zachtemkin/synth-machine-libDaisy/README.md

# synthMachine

## Author

<!-- Insert Your Name Here -->

## Description

<!-- Describe your example here -->
