zachtemkin/synth-machine-libDaisy/hardware/v0.3/README.md

# synthMachine carrier board v0.3

The revision that was fabricated (September 2026). The next revision, with
the fixes from `../NEXT_REVISION.md` applied, is in `../v0.4/`.

A 100 x 100 mm carrier for the Daisy Seed (or Seed3) that drives the synth: the
19-button key matrix, 5 pots, USB-C for MIDI and power, a MAX98306 class-D amp
for the two enclosed Adafruit speakers, and a TPA6138A2 headphone amp with a
switched jack that mutes the speakers when headphones are plugged in.

Buttons and pots stay on the panel and connect with JST-XH leads, so the board
can be mounted anywhere in the enclosure and every panel part unplugs for
service. USB-C, the headphone jack and the Seed's own USB port all sit on the
top board edge, so one enclosure wall carries all three.

Everything here is generated by `gen_kicad.py` so the schematic and the PCB
always agree with each other and with the pin map in `../synthMachine.cpp`.

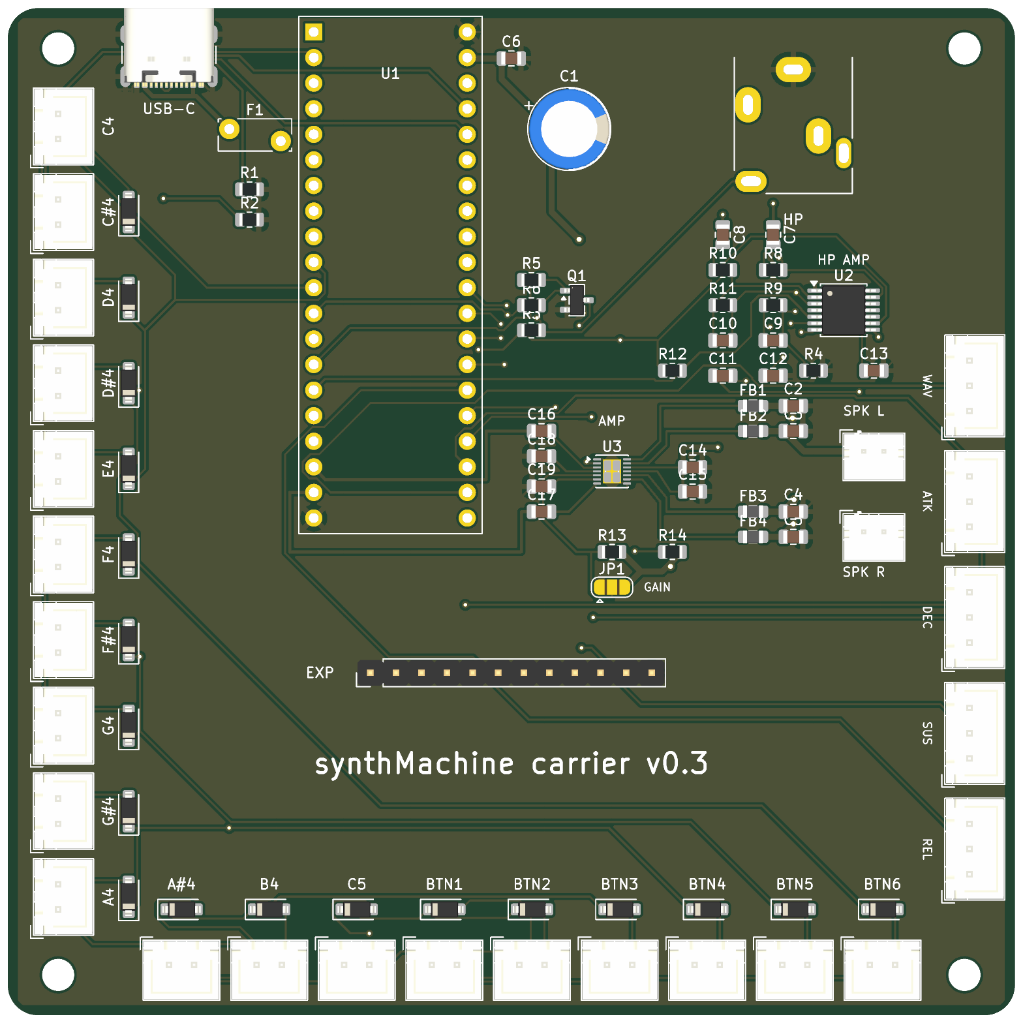
[picture p2: hardware/v0.3/pcb_render.png]
PCB render


## Open it

Open `synth_machine.kicad_pro` in KiCad 9 or 10. ERC is clean (a fresh KiCad 10
install reports "library not in configuration" warnings until it has created
its default library tables on first launch). The PCB is placed and routed with
GND pours on both sides. Remaining DRC items are hole-clearance nits inside
KiCad's own USB-C footprint and a few thermal-spoke notes; both can be ignored.

## Regenerate and route

```bash
KICAD_PY=/Applications/KiCad/KiCad.app/Contents/Frameworks/Python.framework/Versions/Current/bin/python3
$KICAD_PY hardware/v0.3/gen_kicad.py                              # schematic + placed PCB
$KICAD_PY hardware/v0.3/route.py --java <java25>/bin/java --jar freerouting-2.4.1.jar
$KICAD_PY hardware/v0.3/route.py --pours-only                     # rebuild just the GND pours
sh hardware/v0.3/fab.sh                                           # Gerbers, BOM, CPL, test print
```

`gen_kicad.py` overwrites the schematic and PCB, so re-run `route.py` after it.
`route.py` lays down the hand-routed nets in `PREROUTES` (audio paths and the
MAX98306 fan-out) locked, exports a Specctra DSN, runs Freerouting headless
(needs Java 25; a portable JRE from adoptium.net works), imports the result, then
re-adds and fills the pours. Net classes: 0.2 mm default with 0.15 mm clearance,
0.6 mm "Power" for +5V and the filtered speaker lines, 0.4 mm for VBUS, 0.3 mm
for the amp-to-bead speaker lines.

## What is on the board

| Block | Parts | Notes |
|---|---|---|
| Daisy Seed | U1 on 2x 1x20 sockets | USB end on the top board edge. Seed rev 4/5/7 and Seed3 share the pinout. |
| Key headers | K1..K19, JST-XH 2-pin, 10 down the left edge and 9 along the bottom | One lead per button. Pin 1 = matrix row (or D10 for C4), pin 2 = diode (or GND for C4). Silkscreen names each header. |
| Matrix diodes | D1..D18, 1N4148W SOD-123 | Next to each header. Columns D4..D9 driven low, rows D1..D3 with pull-ups, exactly as `scanButtonMatrix()`. |
| Spare buttons | K14..K19 = BTN1..BTN6 | On the 6 unused matrix slots (c0 r0) (c0 r1) (c1 r0) (c2 r0) (c3 r0) (c4 r0), the `-1` entries in `NOTE_MAPPING`. |
| Pot headers | J10..J14, JST-XH 3-pin down the right edge | 1 = +3V3A, 2 = wiper to A0..A4, 3 = AGND. 10k linear panel-mount pots. |
| USB-C | J1 (GCT USB4105), R1/R2 5k1, F1 2.5A polyfuse (Bourns MF-R250) | Data to D30/D29 = Daisy "external" USB; firmware must use `MidiUsbTransport::Config::EXTERNAL`. VBUS is the only power input, no switch. |
| Power | F1 -> +5V; C1 470u, C6 100n | Feeds Seed VIN and the speaker amp. |
| Speaker amp | U3 MAX98306ETD+T (TDFN-14 EP), C16..C19 1u, C14 10u, C15 100n, R13/R14 100k, JP1 | Adafruit #987's circuit on the board, single-ended inputs from the Seed line out. Gain 9 dB via R13 (about 2 W into 4 ohm); JP1 straps GAIN to GND (18 dB) or PVDD (12 dB); no R13 and JP1 open = 6 dB. R14 pulls ~SHDN up, Q1 pulls it low to mute. |
| Speakers | FB1..FB4 0805 beads + C2..C5 220p, J5/J6 JST-PH | MAX98306 datasheet EMI filter, then the JST-PH sockets that match the Adafruit speaker plugs. |
| Headphone amp | U2 TPA6138A2PWR (TSSOP-14), C7/C8 1u, R8..R11 10k, C9/C10 47p, C11/C12 1u, C13 10u, R12 100k | DirectPath: ground-centred output, no output caps, 40 mW into 32 ohm from 3V3. Unity gain (raise R9/R11 for more). Mute active-low, pulled up by R12, D14 can mute it. |
| Headphone jack | J7 CUI SJ1-3515N on the top edge, R3 100k, R4 10k, R5/R6 10k, Q1 MMBT3904 | Tip/ring from U2. The NC switch contact is the plug detect: near 0 V unplugged, about 0.8 V plugged (Q1's base clamps it, see below). Q1 then mutes the speaker amp. D11 = firmware speaker mute, D13 reads HP_DET. |
| Expansion | J8 1x12, fit a female socket | HP_MUTE, D26, D27, A5..A8, HP_DET, MUTE, 3V3, 5V, GND. |
| Mounting | H1..H4 M3, 5 mm in from each corner | |

## Wiring the panel

- **Buttons:** each button gets a 2-pin XH lead with 2.8 mm (0.110") female
  disconnects on the button end. Polarity does not matter. Pre-crimped XH leads
  (Amazon kits, 20 to 30 cm) are the easy route; solder the disconnects on.
- **Pots:** 3-pin XH lead per pot: pin 1 to one outer lug, pin 2 to the wiper,
  pin 3 to the other outer lug. Swap the outer lugs if a pot turns backwards.
- **Speakers:** plug straight into J5/J6. Keep both plugged the same way so the
  speakers stay in phase.
- **Board position:** anywhere. The only constraint is the top edge, which
  needs cutouts for USB-C, the headphone jack and the Seed's USB.

## Why the headphones have their own amp

The MAX98306 outputs are bridge-tied class-D with no ground reference: no series
caps on the speakers, never join the two channels' minus legs, and no headphones
on them (their sleeve is a shared ground). So the headphone jack gets its own
TPA6138A2 driven from the same Seed line out, and the jack's switch contact
mutes the speaker amp. Plug in, speakers go quiet; unplug, they return.

## Ordering (JLCPCB)

`sh hardware/v0.3/fab.sh` writes everything into `hardware/v0.3/fab/`:

- `synth_machine_gerbers.zip`: upload unchanged for the PCB. 2 layers, 100 x
  100 mm, FR-4 1.6 mm, 1 oz, HASL lead-free or ENIG, "remove order number".
- `jlcpcb_bom.csv` and `jlcpcb_cpl.csv`: for SMT assembly, top side, economic.
  Every SMD part carries an LCSC number: the two amps (extended parts), the
  matrix diodes, the ferrite beads, Q1 and all 0805 passives. The CPL
  pre-rotates TSSOP/TDFN parts by -90 degrees for JLC's convention; in the
  placement preview check that U2's and U3's pin-1 dots sit on the silkscreen
  triangles, and that the 18 diodes all show the cathode band on the pin-1 end.
- `synth_machine_1to1_11x17.pdf`: 1:1 print, mostly useful now to check the
  enclosure cutouts on the top edge.

Hand-soldered after assembly: Seed sockets, 19 + 5 XH headers, 2 PH sockets,
the jack, the USB-C receptacle, the fuse and C1. `digikey_tht_parts.csv` is a
Digi-Key list for those plus the XH housings/contacts, pots and speakers.

## Before ordering

1. Seed pin-1 corner on `DaisySeed_2x20` against a real Seed.
2. USB-C and jack positions against your enclosure wall: the USB-C shell
   overhangs the edge by about 1 mm, the jack nose is flush.
3. USB power budget: two 4 ohm speakers at full tilt exceed a USB-A port's
   500 mA. Use a USB-C supply or a 1.5 A-capable port.

## Firmware

`../synthMachine.cpp` builds for this board with `make HW=carrier` (a plain
`make` targets the breadboard prototype). The carrier profile enables
`EXTERNAL` USB MIDI, drives the speaker mute on D11 with the rules below, reads
HP_DET on D13 and holds HP_MUTE (D14) low until a plug is detected.

**v0.3 bug: D13 never sees the plug.** With headphones in, HP_DET only rises
to about 0.8 V, not 3V3: R3 (100k) pulls up through R5 (10k) into Q1's
base-emitter junction, and the divider settles at a diode drop plus a little.
That is enough to switch Q1 on and mute the speakers in hardware, but a digital
input reads it as low, so the firmware never unmutes the headphone amp. The
fix on existing boards is a wire from EXP pin 8 (HP_DET) to EXP pin 4 (A5) and
a firmware built with `HP_DET=adc`, which reads the plug detect through the
ADC with a 0.5 V threshold. The proper fix is in `../NEXT_REVISION.md`, and v0.4 has it.

**Board without its USB-C.** J1 is the only source of +5V, and the Seed does
not pass its own USB supply out through VIN. A carrier built without J1 needs
5 V fed into EXP pin 11 (+5V) with ground on pin 12, or the speaker amp is
unpowered. MIDI then goes through the Seed's own port: build with
`MIDI_USB=seed`.

BTN1 and BTN2 (the left-hand pair on the panel, c0 r0 and c0 r1) are octave
down and up; holding both is shift, which turns the wave-shape pot into master
volume. BTN3..6 pick what the four right-hand pots (A1..A4) control: BTN3 =
envelope (attack, decay, sustain, release; the default), BTN4 = effects
(filter cutoff, resonance, delay, reverb), BTN5 = LFO 1 and BTN6 = LFO 2
(rate, depth, shape, destination). The prototype's spare buttons run the other way through this numbering
(its left pair is c4 r0 and c3 r0), and `AUX_MAPPING` in the firmware carries
both boards.

`make KEYLOG=1` builds a variant that prints every key event on the Seed's
micro-USB serial port (`screen /dev/cu.usbmodem* 115200`) for checking panel
wiring. After any DFU flash, press RESET: the Seed does not bring USB up after
the DFU handoff, so neither MIDI nor the serial log appears until you do.

### MUTE drive rules (this revision)

MUTE (D11) and HP_DET meet at Q1's base through R6 and R5 (10k each), and
HP_DET's pull-up R3 is 100k. So:

- driving MUTE high mutes the speakers regardless of the jack;
- leaving MUTE as an input lets the jack decide;
- driving MUTE **low** holds Q1 off and keeps the speakers on even with
  headphones in, because R6 to ground beats R3. Firmware never drives it low;
  "unmute" is tri-state.

While nothing is plugged in, the jack's switch ties HP_DET to the headphone
amp's left output, so audio peaks above about 0.65 V would turn Q1 on and gate
the speaker amp. Firmware keeps the headphone amp muted (HP_MUTE low) until a
plug is detected, which holds that node near ground.

The speakers default to on at reset, so firmware can only race the codec's
start-up pop (it wins, since GPIO is set before the Seed init), and DFU mode or
a crash leaves them live.

### Next revision

See [NEXT_REVISION.md](NEXT_REVISION.md): the running list of changes for the
next board spin, starting with a separate transistor and pull-up for MUTE so
the speakers default to muted and firmware can use plain push-pull drive.
