zachtemkin/synth-machine-libDaisy/hardware/enclosure-concepts/concept-1-walnut-desktop.png

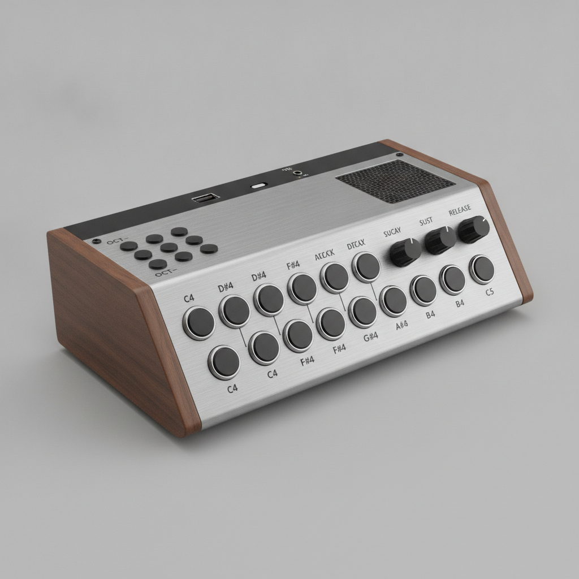
hardware/enclosure-concepts/concept-1-walnut-desktop.png
