zachtemkin/synth-machine-libDaisy/hardware/enclosure-concepts/concept-2-pocket-speaker.png

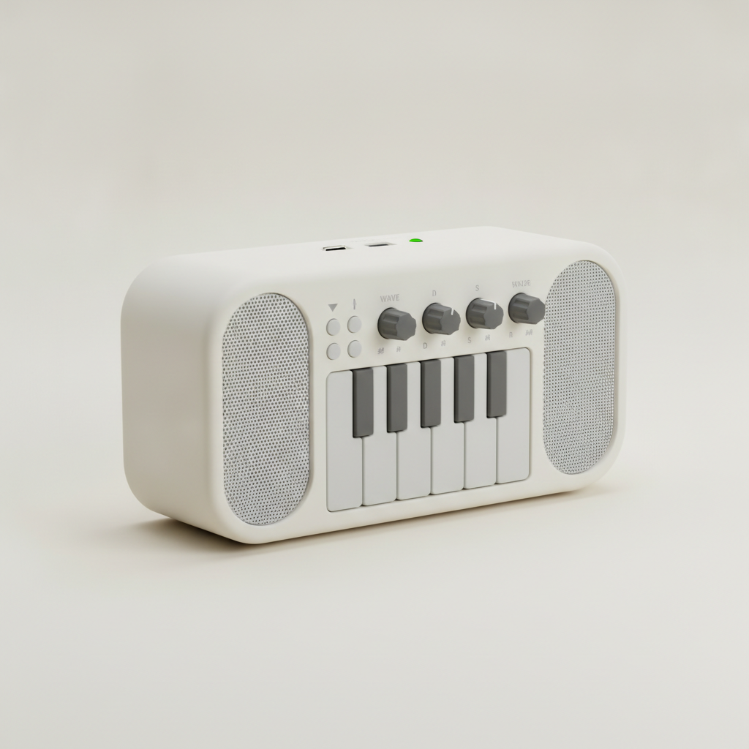
hardware/enclosure-concepts/concept-2-pocket-speaker.png
