zachtemkin/synth-machine-libDaisy/hardware/enclosure-concepts/concept-3-bent-steel.png

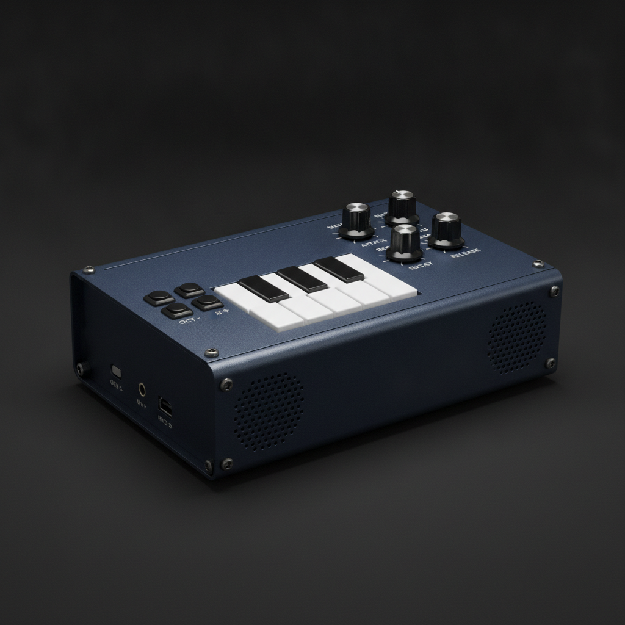
hardware/enclosure-concepts/concept-3-bent-steel.png
