zachtemkin/synth-machine-libDaisy/hardware/v0.4/digikey_tht_parts.csv

Digi-Key Part Number | Manufacturer Part Number | Quantity | Customer Reference | Description
455-2247-ND | B2B-XH-A(LF)(SN) | 42 | K1-K19, J16 x2 + spares | JST XH 2-pin header, vertical (buttons, power switch); skip: placed by JLCPCB standard assembly (C158012)
455-2248-ND | B3B-XH-A(LF)(SN) | 3 | J10 x2 + spare | JST XH 3-pin header, vertical (volume pot); skip: placed by JLCPCB standard assembly (C144394)
455-1704-ND | B2B-PH-K-S(LF)(SN) | 8 | J5,J6,J17 x2 + spares | JST PH 2-pin socket (speakers, battery); skip: placed by JLCPCB standard assembly (C131337)
S7018-ND | PPTC201LFBN-RC | 4 | U1 sockets x2 | 1x20 female header, 2 per Seed
PPTC081LFBN-RC | PPTC081LFBN-RC | 3 | J9 x2 + spare | 1x8 female socket for the display header
PPTC121LFBN-RC | PPTC121LFBN-RC | 3 | J8 x2 + spare | 1x12 female socket for the expansion header
CP1-3515N-ND | SJ1-3515N | 3 | J7 x2 + spare | CUI 3.5mm switched stereo jack
 | TYPE-C-31-M-12 | 0 | J1 | HRO USB-C 16-pin receptacle, LCSC C165948 (JLCPCB basic part); placed by the assembler, not a Digi-Key line
P124219-ND | EEU-FR1A471 | 3 | C1 x2 + spare | Panasonic 470uF 10V radial 8mm, 3.5mm pitch
PDB181-E420K-103B-ND | PDB181-E420K-103B | 3 | volume pot x2 + spare | Bourns 16mm 10k linear pot, solder lugs
 |  | 8 | encoders x2 boards | Adafruit 4991 I2C QT rotary encoder breakout, 4 per board, with STEMMA QT cables; set a different address on each
 |  | 2 | panel power switch | Any panel-mount SPST toggle or slide switch; it only switches the boost's enable pin
 |  | 2 | battery | 1S LiPo 2000 mAh or larger with protection PCB and JST-PH plug (Adafruit 2011 or similar); verify + on J17 pin 1
