zachtemkin/synth-machine-libDaisy/hardware/enclosure-concepts/concept-4-3d-printed.png

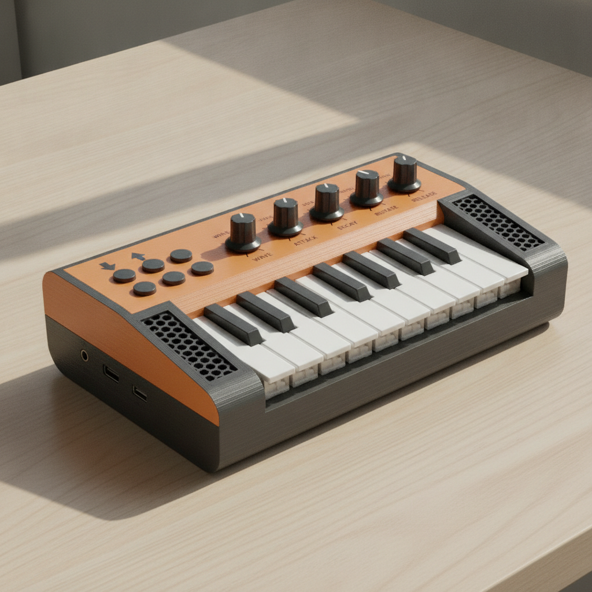
hardware/enclosure-concepts/concept-4-3d-printed.png
