zachtemkin/synth-machine-libDaisy/hardware/v0.4/synth_machine.kicad_pcb

## KiCad design hardware/v0.4/synth_machine.kicad_pcb (2026-09-18)

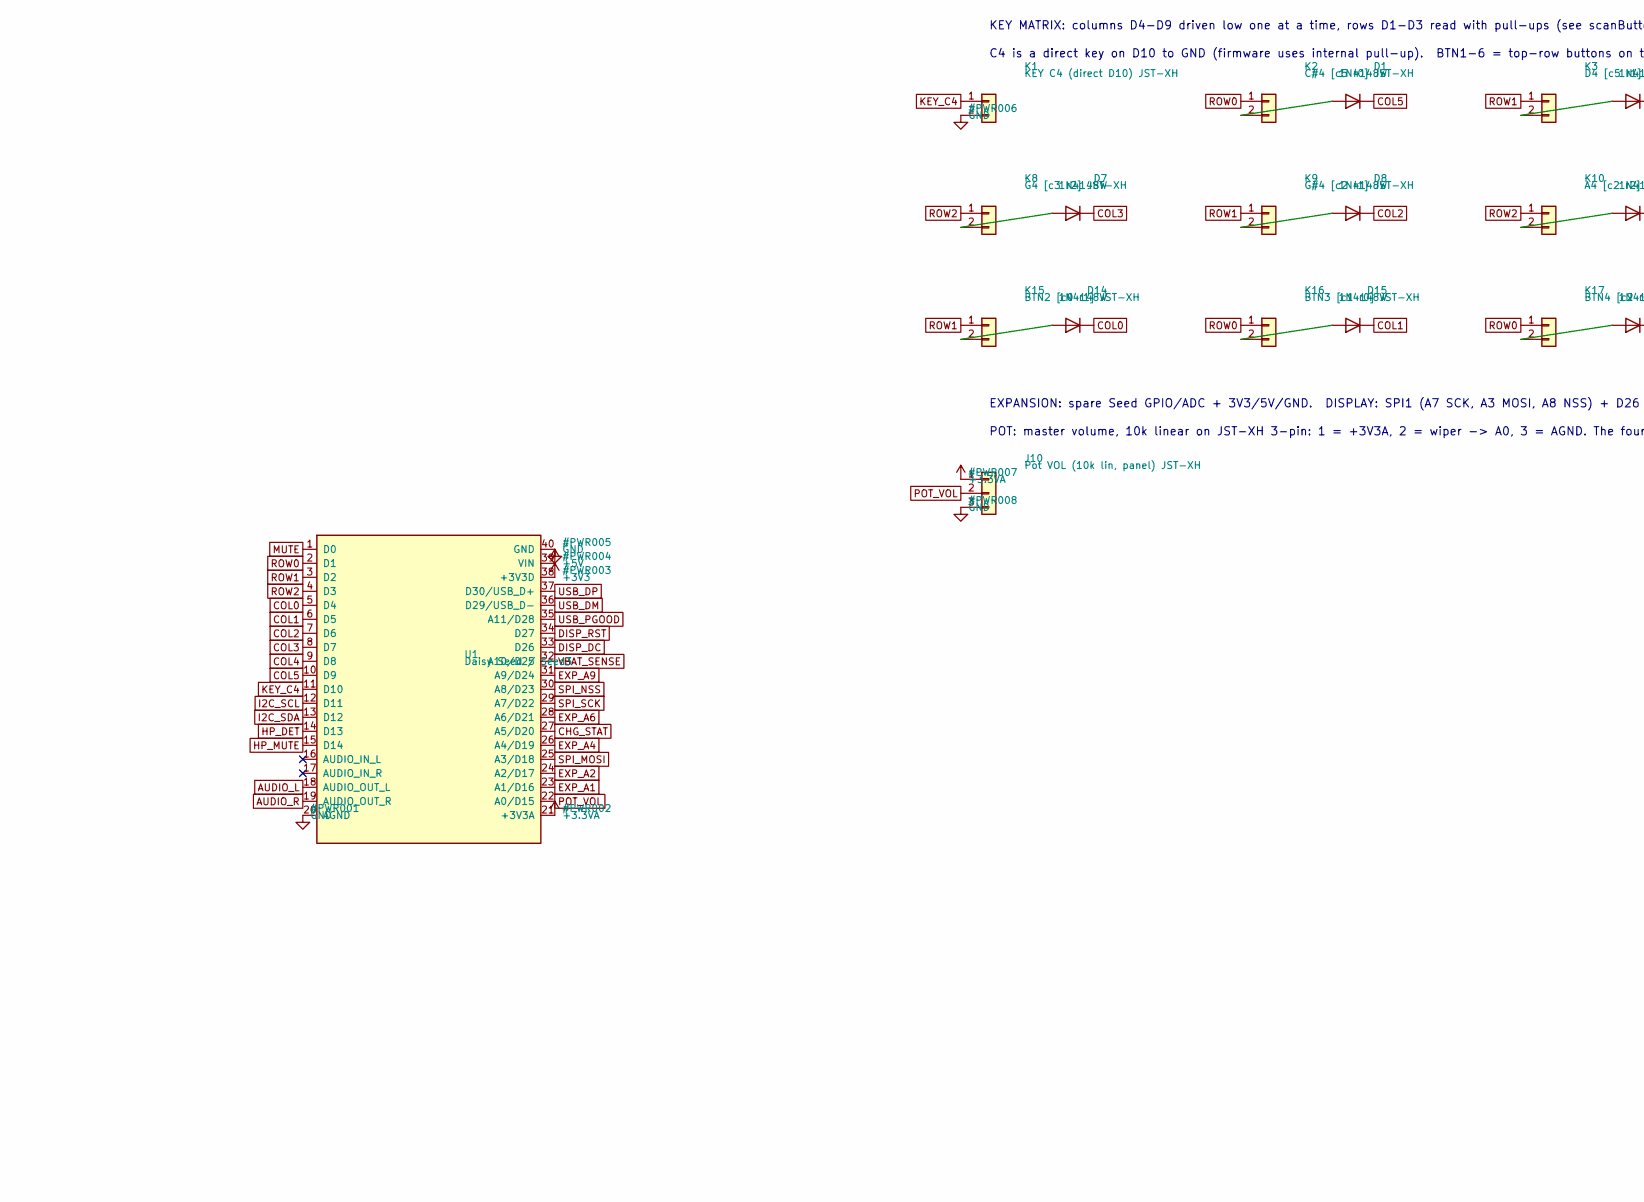
[picture p7: schematic synth_machine.kicad_sch, synthMachine carrier board, part in row 1, column 1]

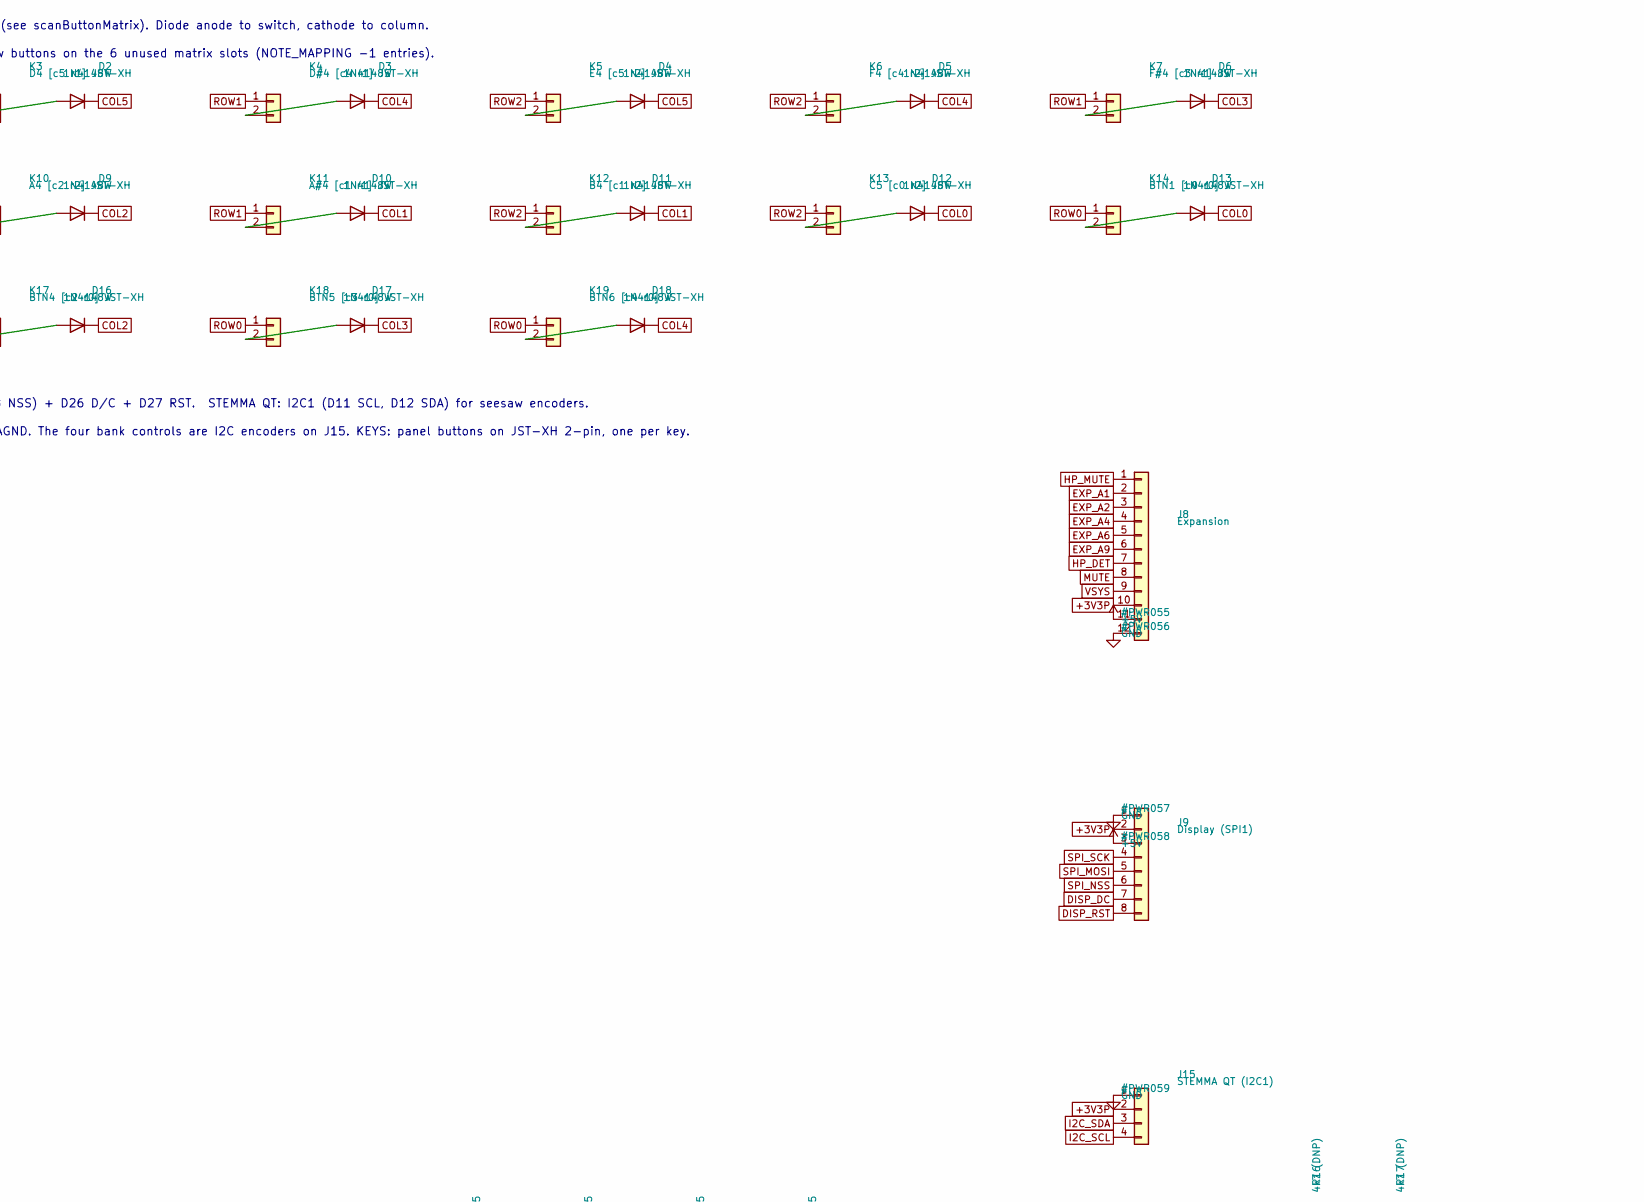
[picture p8: schematic synth_machine.kicad_sch, synthMachine carrier board, part in row 1, column 2]

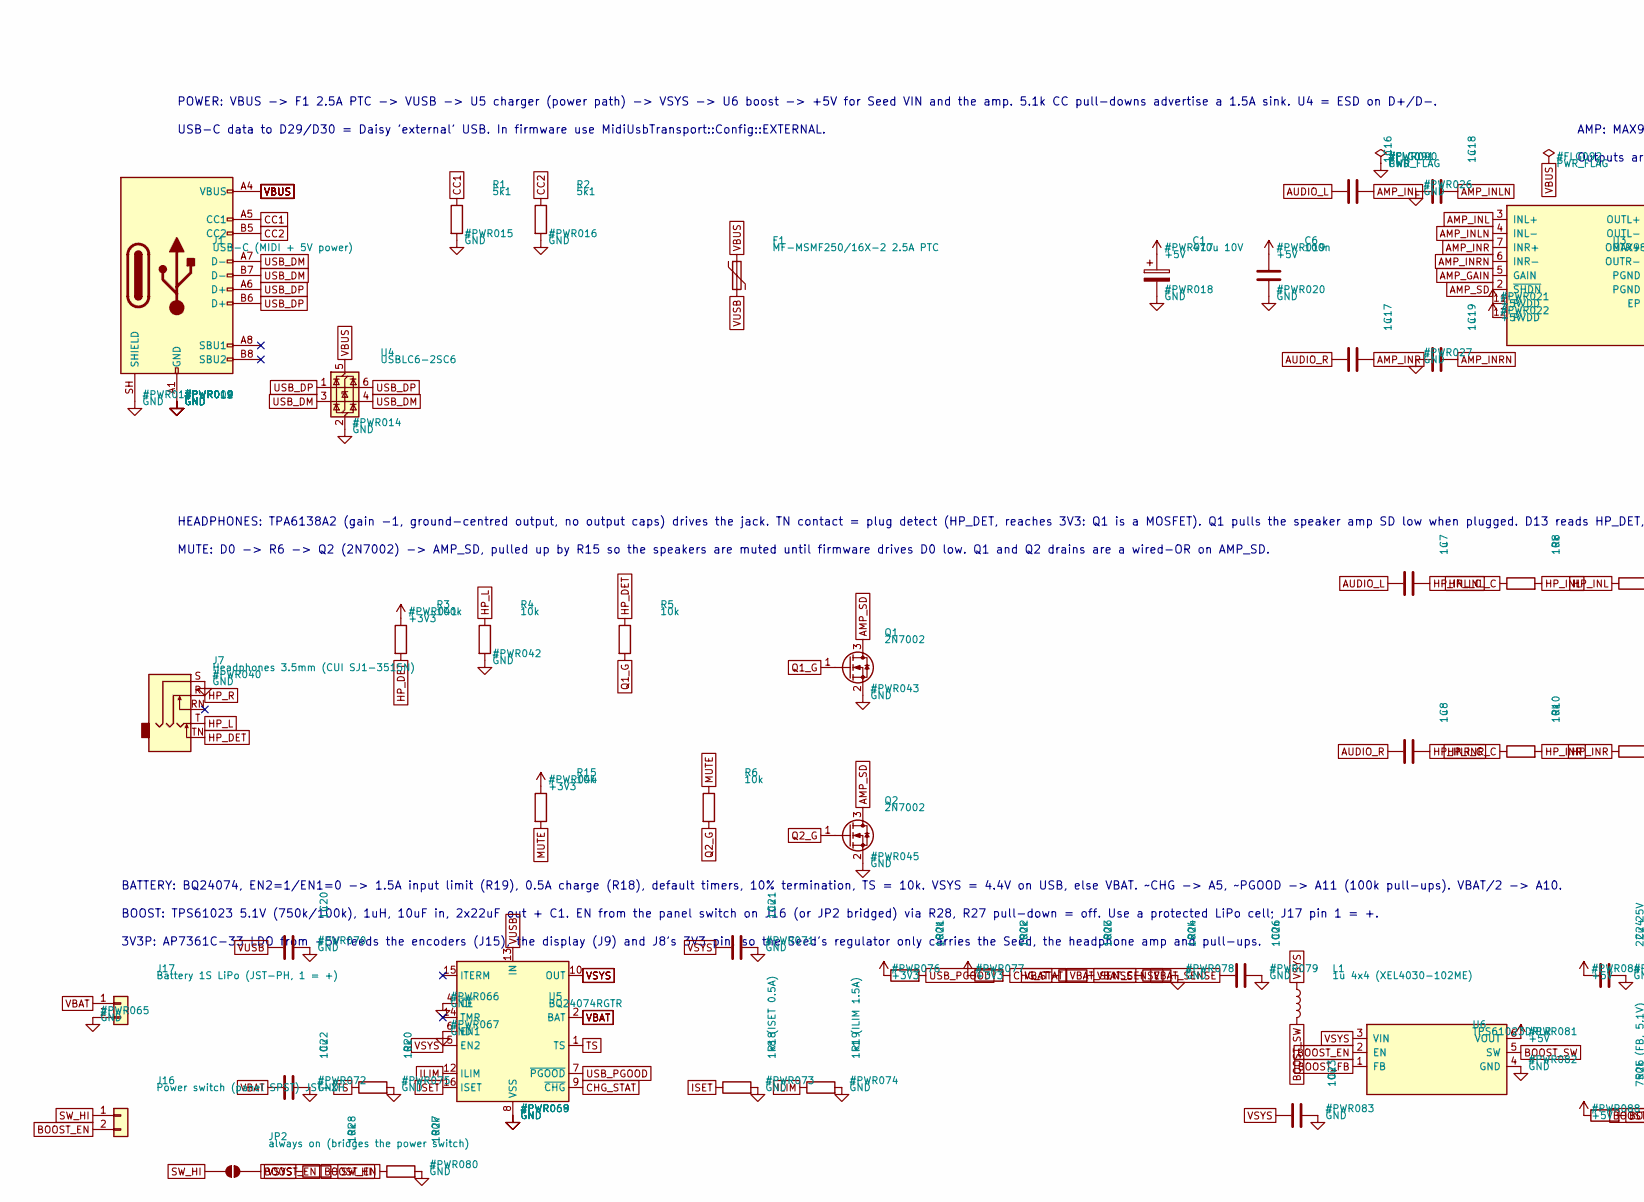
[picture p9: schematic synth_machine.kicad_sch, synthMachine carrier board, part in row 2, column 1]

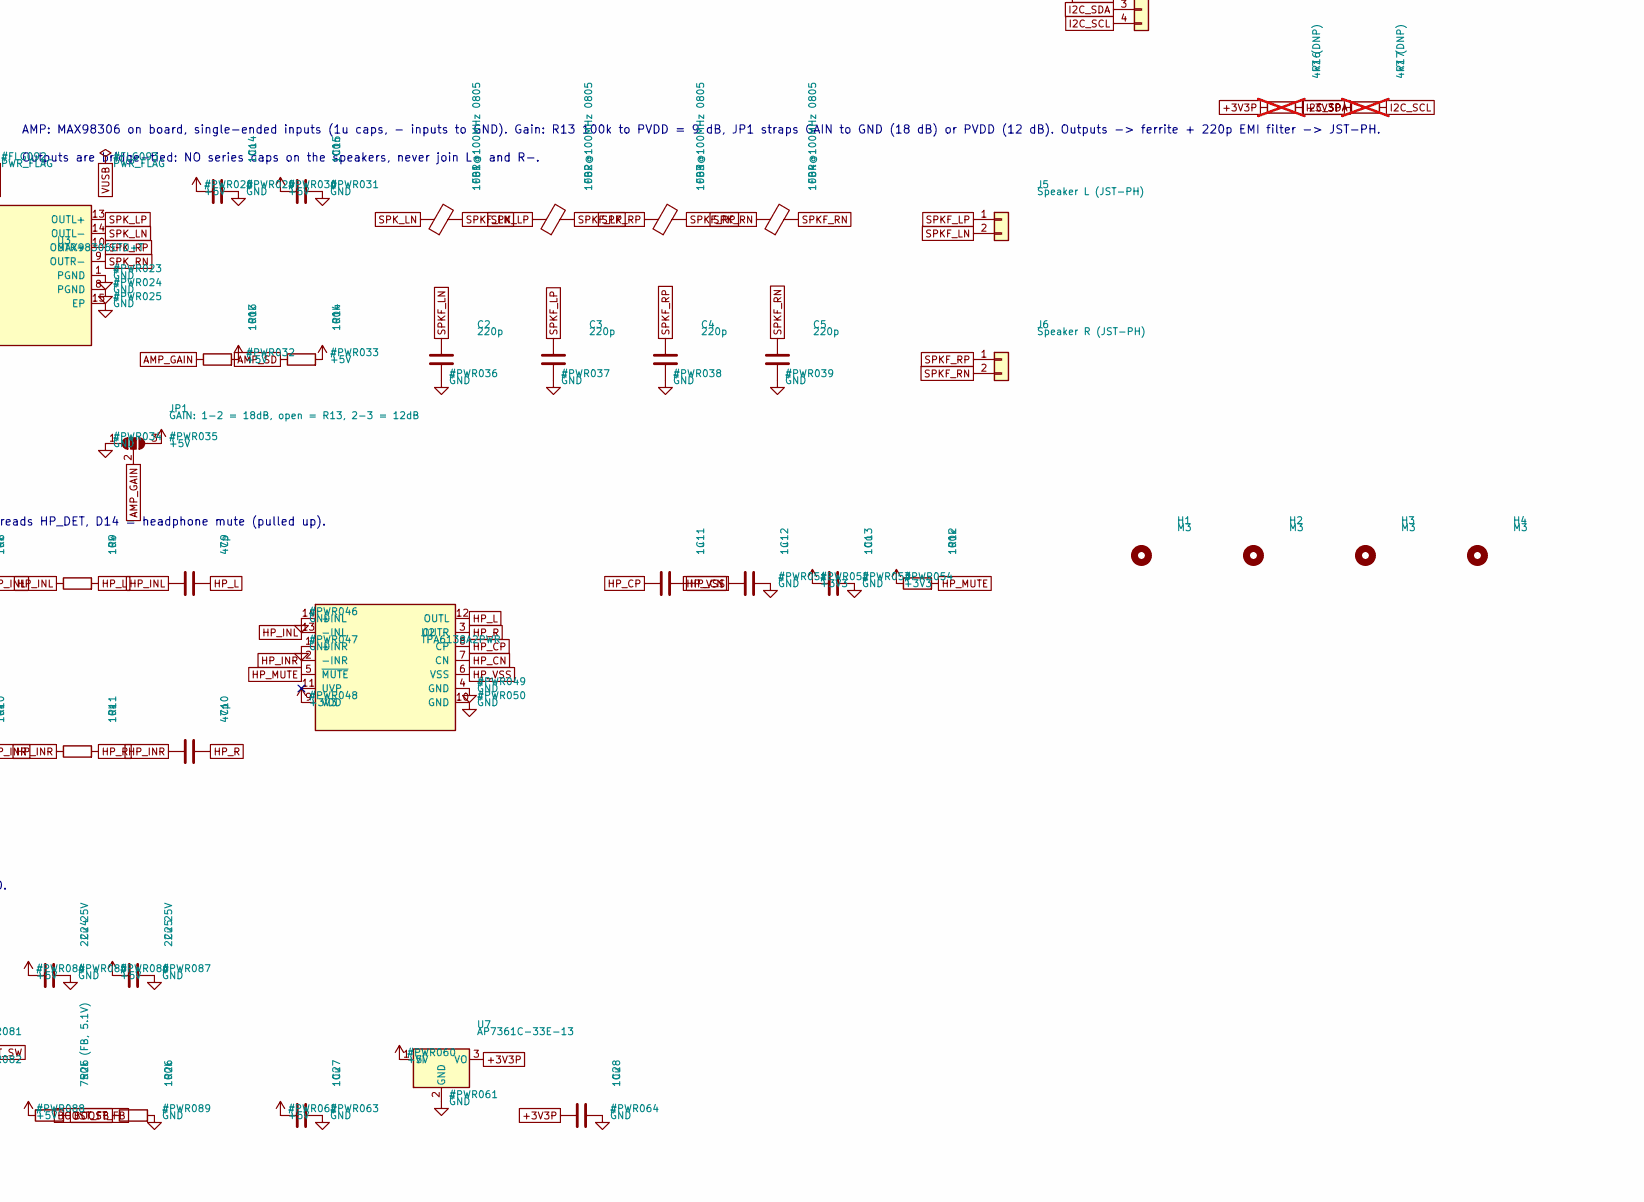
[picture p10: schematic synth_machine.kicad_sch, synthMachine carrier board, part in row 2, column 2]

Parts:
C1: 470u 10V; CP_Radial_D8.0mm_P3.50mm; MPN EEU-FR1A471
C2, C3, C4, C5: 220p; C_0805_2012Metric; LCSC C53172
C6, C15, C26: 100n; C_0805_2012Metric; LCSC C49678
C7, C8, C11, C12, C16, C17, C18, C19, C20: 1u; C_0805_2012Metric; LCSC C28323
C9, C10: 47p; C_0805_2012Metric; LCSC C14857
C13, C14, C21, C22, C23, C27, C28: 10u; C_0805_2012Metric; LCSC C15850
C24, C25: 22u 25V; C_1210_3225Metric; MPN CL32A226KAJNNNE; LCSC C52306
D1, D2, D3, D4, D5, D6, D7, D8, D9, D10, D11, D12, D13, D14, D15, D16, D17, D18: 1N4148W; D_SOD-123; LCSC C81598
F1: MF-MSMF250/16X-2 2.5A PTC; Fuse_1812_4532Metric; MPN MF-MSMF250/16X-2; LCSC C210838
FB1, FB2, FB3, FB4: 100R@100MHz 0805; L_0805_2012Metric; LCSC C1015
H1, H2, H3, H4: M3; MountingHole_3.2mm_M3
J1: USB-C (MIDI + 5V power); USB_C_Receptacle_HRO_TYPE-C-31-M-12; MPN TYPE-C-31-M-12; LCSC C165948
J5: Speaker L (JST-PH); JST_PH_B2B-PH-K_1x02_P2.00mm_Vertical; MPN B2B-PH-K-S(LF)(SN); LCSC C131337
J6: Speaker R (JST-PH); JST_PH_B2B-PH-K_1x02_P2.00mm_Vertical; MPN B2B-PH-K-S(LF)(SN); LCSC C131337
J7: Headphones 3.5mm (CUI SJ1-3515N); Jack_3.5mm_CUI_SJ1-3515N_Horizontal; MPN SJ1-3515N
J8: Expansion; PinHeader_1x12_P2.54mm_Vertical; MPN PPTC121LFBN-RC
J9: Display (SPI1); PinHeader_1x08_P2.54mm_Vertical; MPN PPTC081LFBN-RC
J10: Pot VOL (10k lin, panel) JST-XH; JST_XH_B3B-XH-A_1x03_P2.50mm_Vertical; MPN B3B-XH-A(LF)(SN); LCSC C144394
J15: STEMMA QT (I2C1); JST_SH_BM04B-SRSS-TB_1x04-1MP_P1.00mm_Vertical; MPN BM04B-SRSS-TB(LF)(SN); LCSC C160390
J16: Power switch (panel SPST) JST-XH; JST_XH_B2B-XH-A_1x02_P2.50mm_Vertical; MPN B2B-XH-A(LF)(SN); LCSC C158012
J17: Battery 1S LiPo (JST-PH, 1 = +); JST_PH_B2B-PH-K_1x02_P2.00mm_Vertical; MPN B2B-PH-K-S(LF)(SN); LCSC C131337
JP1: GAIN: 1-2 = 18dB, open = R13, 2-3 = 12dB; SolderJumper-3_P1.3mm_Open_RoundedPad1.0x1.5mm
JP2: always on (bridges the power switch); SolderJumper-2_P1.3mm_Open_RoundedPad1.0x1.5mm
K1: KEY C4 (direct D10) JST-XH; JST_XH_B2B-XH-A_1x02_P2.50mm_Vertical; MPN B2B-XH-A(LF)(SN); LCSC C158012
K2: C#4 [c5 r0] JST-XH; JST_XH_B2B-XH-A_1x02_P2.50mm_Vertical; MPN B2B-XH-A(LF)(SN); LCSC C158012
K3: D4 [c5 r1] JST-XH; JST_XH_B2B-XH-A_1x02_P2.50mm_Vertical; MPN B2B-XH-A(LF)(SN); LCSC C158012
K4: D#4 [c4 r1] JST-XH; JST_XH_B2B-XH-A_1x02_P2.50mm_Vertical; MPN B2B-XH-A(LF)(SN); LCSC C158012
K5: E4 [c5 r2] JST-XH; JST_XH_B2B-XH-A_1x02_P2.50mm_Vertical; MPN B2B-XH-A(LF)(SN); LCSC C158012
K6: F4 [c4 r2] JST-XH; JST_XH_B2B-XH-A_1x02_P2.50mm_Vertical; MPN B2B-XH-A(LF)(SN); LCSC C158012
K7: F#4 [c3 r1] JST-XH; JST_XH_B2B-XH-A_1x02_P2.50mm_Vertical; MPN B2B-XH-A(LF)(SN); LCSC C158012
K8: G4 [c3 r2] JST-XH; JST_XH_B2B-XH-A_1x02_P2.50mm_Vertical; MPN B2B-XH-A(LF)(SN); LCSC C158012
K9: G#4 [c2 r1] JST-XH; JST_XH_B2B-XH-A_1x02_P2.50mm_Vertical; MPN B2B-XH-A(LF)(SN); LCSC C158012
K10: A4 [c2 r2] JST-XH; JST_XH_B2B-XH-A_1x02_P2.50mm_Vertical; MPN B2B-XH-A(LF)(SN); LCSC C158012
K11: A#4 [c1 r1] JST-XH; JST_XH_B2B-XH-A_1x02_P2.50mm_Vertical; MPN B2B-XH-A(LF)(SN); LCSC C158012
K12: B4 [c1 r2] JST-XH; JST_XH_B2B-XH-A_1x02_P2.50mm_Vertical; MPN B2B-XH-A(LF)(SN); LCSC C158012
K13: C5 [c0 r2] JST-XH; JST_XH_B2B-XH-A_1x02_P2.50mm_Vertical; MPN B2B-XH-A(LF)(SN); LCSC C158012
K14: BTN1 [c0 r0] JST-XH; JST_XH_B2B-XH-A_1x02_P2.50mm_Vertical; MPN B2B-XH-A(LF)(SN); LCSC C158012
K15: BTN2 [c0 r1] JST-XH; JST_XH_B2B-XH-A_1x02_P2.50mm_Vertical; MPN B2B-XH-A(LF)(SN); LCSC C158012
K16: BTN3 [c1 r0] JST-XH; JST_XH_B2B-XH-A_1x02_P2.50mm_Vertical; MPN B2B-XH-A(LF)(SN); LCSC C158012
K17: BTN4 [c2 r0] JST-XH; JST_XH_B2B-XH-A_1x02_P2.50mm_Vertical; MPN B2B-XH-A(LF)(SN); LCSC C158012
K18: BTN5 [c3 r0] JST-XH; JST_XH_B2B-XH-A_1x02_P2.50mm_Vertical; MPN B2B-XH-A(LF)(SN); LCSC C158012
K19: BTN6 [c4 r0] JST-XH; JST_XH_B2B-XH-A_1x02_P2.50mm_Vertical; MPN B2B-XH-A(LF)(SN); LCSC C158012
L1: 1u 4x4 (XEL4030-102ME); L_Coilcraft_XxL4030; MPN XEL4030-102MEC
Q1, Q2: 2N7002; SOT-23; MPN 2N7002; LCSC C8545
R1, R2: 5k1; R_0805_2012Metric; LCSC C27834
R3, R12, R13, R14, R21, R22, R23, R24, R26, R27: 100k; R_0805_2012Metric; LCSC C149504
R4, R5, R6, R8, R9, R10, R11, R15, R20, R28: 10k; R_0805_2012Metric; LCSC C17414
R16, R17: 4k7 (DNP); R_0805_2012Metric; not fitted
R18: 1k8 (ISET 0.5A); R_0805_2012Metric; MPN 0805 1% 1.8k
R19: 1k1 (ILIM 1.5A); R_0805_2012Metric; MPN 0805 1% 1.1k
R25: 750k (FB, 5.1V); R_0805_2012Metric; MPN 0805 1% 750k
U1: Daisy Seed / Seed3; DaisySeed_2x20; MPN PPTC201LFBN-RC x2 (sockets; the Seed it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
U2: TPA6138A2PWR; TSSOP-14_4.4x5mm_P0.65mm; MPN TPA6138A2PWR; LCSC C183097
U3: MAX98306ETD+T; TDFN-14-1EP_3x3mm_P0.4mm_EP1.78x2.35mm_ThermalVias; MPN MAX98306ETD+T; LCSC C124549
U4: USBLC6-2SC6; SOT-23-6; MPN USBLC6-2SC6; LCSC C7519
U5: BQ24074RGTR; VQFN-16-1EP_3x3mm_P0.5mm_EP1.6x1.6mm_ThermalVias; MPN BQ24074RGTR; LCSC C54313
U6: TPS61023DRLR; SOT-563; MPN TPS61023DRLR; LCSC C919459
U7: AP7361C-33E-13; SOT-223-3_TabPin2; MPN AP7361C-33E-13; LCSC C500795

Connections:
+3.3VA: J10.1, U1.21 (+3V3A)
+3V3: C13.1, R3.1, R12.1, R15.1, R21.1, R22.1, U1.38 (+3V3D), U2.9 (VDD)
+3V3P: C28.1, J8.10, J9.2, J15.2, R16.1, R17.1, U7.3 (VO)
+5V: C1.1, C6.1, C14.1, C15.1, C24.1, C25.1, C27.1, J8.11, J9.3, JP1.3 (B), R13.2, R14.2, R25.1, U1.39 (VIN), U3.11 (PVDD), U3.12 (PVDD), U6.6 (VOUT), U7.1 (VI)
AMP_GAIN: JP1.2 (C), R13.1, U3.5 (GAIN)
AMP_INL: C16.2, U3.3 (INL+)
AMP_INLN: C18.2, U3.4 (INL-)
AMP_INR: C17.2, U3.7 (INR+)
AMP_INRN: C19.2, U3.6 (INR-)
AMP_SD: Q1.3 (D), Q2.3 (D), R14.1, U3.2 (~SHDN)
AUDIO_L: C7.1, C16.1, U1.18 (AUDIO_OUT_L)
AUDIO_R: C8.1, C17.1, U1.19 (AUDIO_OUT_R)
BOOST_EN: J16.2, JP2.2 (B), R27.1, U6.2 (EN)
BOOST_FB: R25.2, R26.1, U6.1 (FB)
BOOST_SW: L1.2, U6.5 (SW)
CC1: J1.A5 (CC1), R1.1
CC2: J1.B5 (CC2), R2.1
CHG_STAT: R22.2, U1.27 (A5/D20), U5.9 (~CHG)
COL0: D12.1 (K), D13.1 (K), D14.1 (K), U1.5 (D4)
COL1: D10.1 (K), D11.1 (K), D15.1 (K), U1.6 (D5)
COL2: D8.1 (K), D9.1 (K), D16.1 (K), U1.7 (D6)
COL3: D6.1 (K), D7.1 (K), D17.1 (K), U1.8 (D7)
COL4: D3.1 (K), D5.1 (K), D18.1 (K), U1.9 (D8)
COL5: D1.1 (K), D2.1 (K), D4.1 (K), U1.10 (D9)
DISP_DC: J9.7, U1.33 (D26)
DISP_RST: J9.8, U1.34 (D27)
EXP_A1: J8.2, U1.23 (A1/D16)
EXP_A2: J8.3, U1.24 (A2/D17)
EXP_A4: J8.4, U1.26 (A4/D19)
EXP_A6: J8.5, U1.28 (A6/D21)
EXP_A9: J8.6, U1.31 (A9/D24)
GND: C1.2, C2.2, C3.2, C4.2, C5.2, C6.2, C12.2, C13.2, C14.2, C15.2, C18.1, C19.1, C20.2, C21.2, C22.2, C23.2, C24.2, C25.2, C26.2, C27.2, C28.2, J1.A1 (GND), J1.A12 (GND), J1.B1 (GND), J1.B12 (GND), J1.SH (SHIELD), J7.S, J8.12, J9.1, J10.3, J15.1, J17.2, JP1.1 (A), K1.2, Q1.2 (S), Q2.2 (S), R1.2, R2.2, R4.2, R18.2, R19.2, R20.2, R24.2, R26.2, R27.2, U1.20 (AGND), U1.40 (GND), U2.1 (+INR), U2.4 (GND), U2.10 (GND), U2.14 (+INL), U3.1 (PGND), U3.8 (PGND), U3.15 (EP), U4.2 (GND), U5.4 (~CE), U5.6 (EN1), U5.8 (VSS), U5.17 (VSS), U6.4 (GND), U7.2 (GND)
HP_CN: C11.2, U2.7 (CN)
HP_CP: C11.1, U2.8 (CP)
HP_DET: J7.TN, J8.7, R3.2, R5.1, U1.14 (D13)
HP_INL: C9.1, R8.2, R9.1, U2.13 (-INL)
HP_INL_C: C7.2, R8.1
HP_INR: C10.1, R10.2, R11.1, U2.2 (-INR)
HP_INR_C: C8.2, R10.1
HP_L: C9.2, J7.T, R4.1, R9.2, U2.12 (OUTL)
HP_MUTE: J8.1, R12.2, U1.15 (D14), U2.5 (~MUTE)
HP_R: C10.2, J7.R, R11.2, U2.3 (OUTR)
HP_VSS: C12.1, U2.6 (VSS)
I2C_SCL: J15.4, R17.2, U1.12 (D11)
I2C_SDA: J15.3, R16.2, U1.13 (D12)
ILIM: R19.1, U5.12 (ILIM)
ISET: R18.1, U5.16 (ISET)
KA4_D: D9.2 (A), K10.2
KAs4_D: D10.2 (A), K11.2
KB4_D: D11.2 (A), K12.2
KBTN1_D: D13.2 (A), K14.2
KBTN2_D: D14.2 (A), K15.2
KBTN3_D: D15.2 (A), K16.2
KBTN4_D: D16.2 (A), K17.2
KBTN5_D: D17.2 (A), K18.2
KBTN6_D: D18.2 (A), K19.2
KC5_D: D12.2 (A), K13.2
KCs4_D: D1.2 (A), K2.2
KD4_D: D2.2 (A), K3.2
KDs4_D: D3.2 (A), K4.2
KE4_D: D4.2 (A), K5.2
KEY_C4: K1.1, U1.11 (D10)
KF4_D: D5.2 (A), K6.2
KFs4_D: D6.2 (A), K7.2
KG4_D: D7.2 (A), K8.2
KGs4_D: D8.2 (A), K9.2
MUTE: J8.8, R6.1, R15.2, U1.1 (D0)
POT_VOL: J10.2, U1.22 (A0/D15)
Q1_G: Q1.1 (G), R5.2
Q2_G: Q2.1 (G), R6.2
ROW0: K2.1, K14.1, K16.1, K17.1, K18.1, K19.1, U1.2 (D1)
ROW1: K3.1, K4.1, K7.1, K9.1, K11.1, K15.1, U1.3 (D2)
ROW2: K5.1, K6.1, K8.1, K10.1, K12.1, K13.1, U1.4 (D3)
SPI_MOSI: J9.5, U1.25 (A3/D18)
SPI_NSS: J9.6, U1.30 (A8/D23)
SPI_SCK: J9.4, U1.29 (A7/D22)
SPKF_LN: C2.1, FB1.2, J5.2
SPKF_LP: C3.1, FB2.2, J5.1
SPKF_RN: C5.1, FB4.2, J6.2
SPKF_RP: C4.1, FB3.2, J6.1
SPK_LN: FB1.1, U3.14 (OUTL-)
SPK_LP: FB2.1, U3.13 (OUTL+)
SPK_RN: FB4.1, U3.9 (OUTR-)
SPK_RP: FB3.1, U3.10 (OUTR+)
SW_HI: J16.1, JP2.1 (A), R28.2
TS: R20.1, U5.1 (TS)
USB_DM: J1.A7 (D-), J1.B7 (D-), U1.36 (D29/USB_D-), U4.3 (I/O2), U4.4 (I/O2)
USB_DP: J1.A6 (D+), J1.B6 (D+), U1.37 (D30/USB_D+), U4.1 (I/O1), U4.6 (I/O1)
USB_PGOOD: R21.2, U1.35 (A11/D28), U5.7 (~PGOOD)
VBAT: C22.1, J17.1, R23.1, U5.2 (BAT), U5.3 (BAT)
VBAT_SENSE: C26.1, R23.2, R24.1, U1.32 (A10/D25)
VBUS: F1.1, J1.A4 (VBUS), J1.A9 (VBUS), J1.B4 (VBUS), J1.B9 (VBUS), U4.5 (VBUS)
VSYS: C21.1, C23.1, J8.9, L1.1, R28.1, U5.5 (EN2), U5.10 (OUT), U5.11 (OUT), U6.3 (VIN)
VUSB: C20.1, F1.2, U5.13 (IN)

Notes on the sheet:
KEY MATRIX: columns D4-D9 driven low one at a time, rows D1-D3 read with pull-ups (see scanButtonMatrix). Diode anode to switch, cathode to column.
C4 is a direct key on D10 to GND (firmware uses internal pull-up). BTN1-6 = top-row buttons on the 6 unused matrix slots (NOTE_MAPPING -1 entries).
POT: master volume, 10k linear on JST-XH 3-pin: 1 = +3V3A, 2 = wiper -> A0, 3 = AGND. The four bank controls are I2C encoders on J15. KEYS: panel buttons on JST-XH 2-pin, one per key.
POWER: VBUS -> F1 2.5A PTC -> VUSB -> U5 charger (power path) -> VSYS -> U6 boost -> +5V for Seed VIN and the amp. 5.1k CC pull-downs advertise a 1.5A sink. U4 = ESD on D+/D-.
USB-C data to D29/D30 = Daisy 'external' USB. In firmware use MidiUsbTransport::Config::EXTERNAL.
AMP: MAX98306 on board, single-ended inputs (1u caps, - inputs to GND). Gain: R13 100k to PVDD = 9 dB, JP1 straps GAIN to GND (18 dB) or PVDD (12 dB). Outputs -> ferrite + 220p EMI filter -> JST-PH.
Outputs are bridge-tied: NO series caps on the speakers, never join L- and R-.
HEADPHONES: TPA6138A2 (gain -1, ground-centred output, no output caps) drives the jack. TN contact = plug detect (HP_DET, reaches 3V3: Q1 is a MOSFET). Q1 pulls the speaker amp SD low when plugged. D13 reads HP_DET, D14 = headphone mute (pulled up).
MUTE: D0 -> R6 -> Q2 (2N7002) -> AMP_SD, pulled up by R15 so the speakers are muted until firmware drives D0 low. Q1 and Q2 drains are a wired-OR on AMP_SD.
BATTERY: BQ24074, EN2=1/EN1=0 -> 1.5A input limit (R19), 0.5A charge (R18), default timers, 10% termination, TS = 10k. VSYS = 4.4V on USB, else VBAT. ~CHG -> A5, ~PGOOD -> A11 (100k pull-ups). VBAT/2 -> A10.
BOOST: TPS61023 5.1V (750k/100k), 1uH, 10uF in, 2x22uF out + C1. EN from the panel switch on J16 (or JP2 bridged) via R28, R27 pull-down = off. Use a protected LiPo cell; J17 pin 1 = +.
3V3P: AP7361C-33 LDO from +5V feeds the encoders (J15), the display (J9) and J8's 3V3 pin, so the Seed's regulator only carries the Seed, the headphone amp and pull-ups.
EXPANSION: spare Seed GPIO/ADC + 3V3/5V/GND. DISPLAY: SPI1 (A7 SCK, A3 MOSI, A8 NSS) + D26 D/C + D27 RST. STEMMA QT: I2C1 (D11 SCL, D12 SDA) for seesaw encoders.

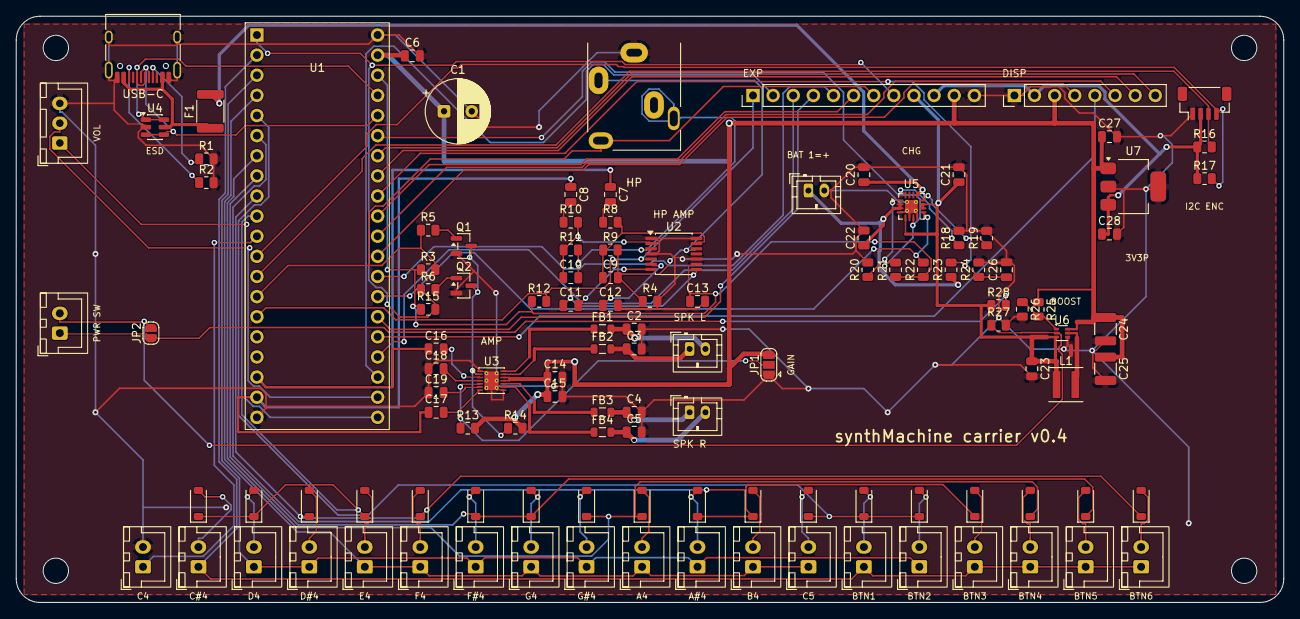
[picture p11: board synth_machine.kicad_pcb from above]

Board: 2 copper layers, 160.0 x 74.0 mm, 123 parts (0 on the bottom side), 94 nets.
