zachtemkin/synth-machine-libDaisy/(commit log)

2026-09-03 Add KiCad carrier board stub for the synthMachine panel
    Generated KiCad 9 project (hardware/gen_kicad.py emits schematic + PCB from
    one netlist) for a PCB that sits under the 234.95 x 161.925 mm button panel:
    - Daisy Seed on 2x20 sockets, pin map matching synthMachine.cpp
    - 19 arcade buttons (13 keys + 6 spare on the unused matrix slots) plugging
    into Keystone 3534 quick-fit receptacles, with 1N4148 matrix diodes
    - 3-pin headers for 5 panel-mount pots at the panel's O7 holes
    - USB-C for MIDI (D29/D30) and 5V power via a polyfuse and panel switch
    - Adafruit MAX98306 amp breakout header, ferrite + 220p speaker EMI filter,
    JST-PH speaker headers
    - TPA6138A2 headphone amp on a switched 3.5m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
    [synth_machine.kicad_pcb, synth_machine.kicad_sch]
2026-09-03 Route the carrier board and fix the button tab pitch
    - Button tab pitch measured 9.05 mm outer-to-outer (2.8 mm tabs), so the
    Keystone 3534 receptacle pairs now sit on 6.25 mm centres
    - hardware/route.py: Specctra export -> Freerouting (headless, Java 25) ->
    session import -> GND pours on both layers -> fill. Pours are stripped
    before export so GND is routed with real tracks/vias
    - Net classes: 0.25 mm default, 0.6 mm Power (+5V, speaker lines),
    0.4 mm USB_Power for VBUS
    - Board is fully routed: 781 segments, 46 vias, 0 unrouted, DRC clean
    apart from USB-C library hole-clearance nits and two thermal-spoke notes
    [synth_machine.kicad_pcb, synth_machine.kicad_sch]
2026-09-03 Seat the USB-C receptacle on the board edge, harden route.py
    - J1 moved so the footprint's "PCB Edge" guide line sits on the outline
    (shell overhangs ~1 mm as intended); board re-routed, still 0 unrouted
    - route.py runs the pour step in a fresh interpreter (SWIG ownership crash
    when reloading the board in the same process)
    - README: connector-edge check added to the pre-order list
    [synth_machine.kicad_pcb, synth_machine.kicad_sch]
2026-09-03 Hand-route the audio nets, move headphone amp and jack to the left edge
    - PREROUTES in gen_kicad.py: AUDIO_L/R from the Seed line out to the amp
    header (nested L shapes, F.Cu) and to the headphone amp input caps
    (B.Cu with a via at each cap), 0.3 mm, laid down locked by route.py before
    Freerouting so the autorouter works around them; verified 18/18 kept
    - Headphone amp cluster and jack relocated to the left edge between BTN1 and
    C#4, shrinking the audio runs from ~100 mm to ~20 mm
    - Speaker EMI caps moved left of the ferrite beads, out of the audio path
    - route.py keeps removed tracks/zones referenced (pcbnew crashes otherwise)
    - Board: 770 segments, 48 vias, 0 unrouted, DRC clean ap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
    [synth_machine.kicad_pcb, synth_machine.kicad_sch]
2026-09-04 Add fabrication output script and ordering notes
    hardware/fab.sh produces the Gerber/drill zip, a grouped BOM and a
    position CSV with kicad-cli using the JLCPCB/PCBWay recommended plot
    settings; README gets an ordering section with the board parameters.
2026-09-04 fab.sh: also emit a 1:1 test-print PDF on 11x17
2026-09-04 fab.sh: centre the 1:1 test print on a landscape 11x17 page
2026-09-04 Drop the panel power switch and LED header; KiCad 10 compatibility
    - J3 removed: the polyfuse now feeds +5V directly (unplug USB to power off)
    - J9/R7 removed, D12 is free again
    - USB-C shield pad is "SH" in the KiCad 10 footprint library (was S1); the
    generator maps both so the shield stays on GND
    - re-routed with the locked audio pre-routes: 805 segments, 48 vias, 0 unrouted
    [synth_machine.kicad_pcb, synth_machine.kicad_sch]
2026-09-04 Put the MAX98306 on the board and prepare for JLCPCB SMT assembly
    - U3 MAX98306ETD+T (TDFN-14, thermal vias) replaces the Adafruit breakout
    header A1 and the speaker return header J4; 1u input caps, 10u + 100n
    decoupling, 100k SHDN pull-up, 100k gain resistor (9 dB) and a 3-pad
    solder jumper for 12/18 dB
    - amp fan-out hand-routed: 0.2 mm stubs from the 0.4 mm pitch pads, vias,
    0.3 mm B.Cu bus to the ferrite beads; speaker nets renamed to P/N so
    KiCad/Freerouting stop treating them as differential pairs
    - design rules 0.2 mm track / 0.15 mm clearance / 0.2 mm min drill
    - all SMD passives are 0805 with LCSC codes; CC pull-downs and the
    headphone-detect resistors moved from axial to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
    [synth_machine.kicad_pcb, synth_machine.kicad_sch]
2026-09-04 BOM: 100k 0805 -> C96346 (C17407 out of stock at JLCPCB)
2026-09-04 BOM: 100k 0805 -> C149504 (basic, in stock)
2026-09-04 Add Digi-Key list for the through-hole parts
    [digikey_tht_parts.csv]
2026-09-04 Digi-Key list: use manufacturer numbers for the bead and fuse
    [digikey_tht_parts.csv]
2026-09-04 Digi-Key list: F1 is Bourns MF-R250 (MF-R250-ND)
    [digikey_tht_parts.csv]
2026-09-04 Digi-Key list: ferrite beads are Fair-Rite 2944666671
    [digikey_tht_parts.csv]
2026-09-07 Carrier v0.3: compact 100x100 board, JST-XH leads for buttons and pots
    - Buttons no longer plug into the board: one JST-XH 2-pin header per key
    (10 down the left edge, 9 along the bottom), pots on JST-XH 3-pin headers
    down the right edge; board shrinks to 100 x 100 mm (JLC cheap tier)
    - USB-C, headphone jack and the Seed's own USB all on the top edge
    - Seed3 supported (same pinout/outline as the original Seed)
    - more SMT for JLC: 1N4148W SOD-123 diodes, 0805 ferrite beads, MMBT3904
    SOT-23, 0805 100n; hand-solder list is now connectors, sockets, fuse, C1
    - audio pre-routes reworked for the new geometry (no crossings), amp
    fan-out kept; 808 segments, 46 vias, 0 unrouted, DRC clean apar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
    [digikey_tht_parts.csv, synth_machine.kicad_pcb, synth_machine.kicad_sch]
2026-09-07 v0.3 silkscreen tidy-up
    - hide designators on holes, diodes, key/pot/speaker headers, USB-C, jack
    and expansion header; functional labels (key names, WAV..REL, SPK L/R,
    USB-C, HP, EXP) carry the silkscreen
    - left-side matrix diodes rotated to sit parallel to their headers like the
    bottom row
    - headphone-amp passives on a 5 x 3.5 mm grid, R4/R12/C13 pulled out of it
    - expansion header centred under the Seed
    - re-routed: 0 unrouted, DRC clean apart from known library nits
    [synth_machine.kicad_pcb, synth_machine.kicad_sch]
2026-09-07 v0.3 silkscreen: edge labels rotated to sit on the board edge, title moved up
    [synth_machine.kicad_pcb, synth_machine.kicad_sch]
2026-09-07 v0.3 silkscreen: bottom-row key labels sit just above their diodes
    Also gives the amp's +5V decoupling island a locked exit stub and via so the
    autorouter can always reach it (it was boxed in by the speaker fan-out).
    [synth_machine.kicad_pcb, synth_machine.kicad_sch]
2026-09-07 Digi-Key list: drop XH housings/contacts (using pre-made XH leads)
    [digikey_tht_parts.csv]
2026-09-07 Digi-Key list: drop the speakers (already on hand)
    [digikey_tht_parts.csv]
2026-09-07 J8 expansion header becomes a 1x12 female socket; Digi-Key list sized for two boards
    [digikey_tht_parts.csv, synth_machine.kicad_pcb, synth_machine.kicad_sch]
2026-09-07 Keep the J8 pin-header footprint; Digi-Key list sized for two boards with female sockets for J8
    Board files restored to the eda5d51 state (identical to what was uploaded to
    JLCPCB); a 1x12 female socket solders into the same holes.
    [digikey_tht_parts.csv, synth_machine.kicad_pcb, synth_machine.kicad_sch]
2026-09-07 Digi-Key list: order the 1x12 socket by manufacturer number
    [digikey_tht_parts.csv]
2026-09-07 Add hardware profiles: prototype (default) and carrier board
    One firmware, two builds. `make` targets the breadboard prototype as
    before; `make HW=carrier` targets the carrier board in hardware/ and
    builds into build-carrier/.
    Carrier profile:
    - USB MIDI on the EXTERNAL transport (board USB-C on D29/D30)
    - D11 speaker mute driven push-pull high, tri-stated to run, never low
    (a low drive would defeat the headphone jack's plug-detect through Q1)
    - D13 headphone detect with an integrating debounce; D14 holds the
    TPA6138A2 muted until a plug is seen, which also keeps the jack's
    detect node quiet so audio can't chatter the speaker amp
    Both profiles now mute the amps before hw.Init(), ahea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
2026-09-07 Octave buttons, shift-to-volume, external USB MIDI on both boards
    - USB MIDI now uses the EXTERNAL transport (D29/D30, the USB-C) on the
    prototype as well as the carrier. Verified end to end on the prototype.
    - Left spare-button pair: octave down/up, two octaves each way, applied to
    new notes, acting on release. Holding both is shift, which hands the
    wave-shape pot to master volume (square law, smoothed in the callback).
    When the pot is handed to a parameter it doesn't match, turning it scales
    the parameter toward the knob instead of jumping.
    - AUX_MAPPING per board: carrier BTN1/BTN2 (c0 r0, c0 r1); prototype
    c4 r0 / c3 r0, its spare buttons run the other way through the carrier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
    [synthMachine.cpp]
2026-09-07 Add next-revision hardware notes and the midimon bring-up tool
    - hardware/NEXT_REVISION.md: running list for the next carrier spin. Leads
    with a separate transistor and 10k pull-up for MUTE so the speakers
    default to muted and firmware can use push-pull drive; also a panel
    status LED and the HP_DET-while-unplugged note. Records the two things
    that turned out not to be hardware problems (the cable, and the RESET
    needed after DFU).
    - tools/midimon.swift: CoreMIDI monitor that prints every message from
    every source, picking up sources that appear later. `make tools/midimon`
    builds it. tools/README.md covers it and the KEYLOG serial key log.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
2026-09-09 Pot modes: envelope, effects, and two LFOs on the four spare buttons
    The four remaining spare buttons (BTN3..6 on the carrier) now pick what
    the four right-hand pots (A1..A4) control:
    1 envelope attack, decay, sustain, release (default)
    2 effects filter cutoff, resonance, delay, reverb
    3 LFO 1 rate, depth, shape, destination
    4 LFO 2 rate, depth, shape, destination
    - Every pot-driven parameter now goes through the takeover logic the
    wave-shape/volume pot already had, so switching banks never makes a
    sound jump. The envelope bank still snaps to the knobs on boot.
    - New signal chain: voices -> Svf low-pass -> delay -> reverb (ReverbSc,
    stereo) -> soft limiter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
    [synthMachine.cpp]
2026-09-09 Next revision: display header on a freed SPI1
    J8's spare pins don't form a hardware SPI or I2C port, so a display on the
    current board must be bit-banged (fine for a small OLED, not a TFT). Note
    the fix: move the A3 pot to A9 to free PA7 as SPI1 MOSI and add a display
    header with SCK/MOSI/NSS, D/C, reset and power.
    Claude-Session: https://claude.ai/code/session_019ZDGV5fm4G7LwUwRWHEiwx
2026-09-17 Carrier v0.3 bring-up: build options for the first unit, hardware notes
    First carrier board is running (Seed3, no USB-C fitted, pots not yet wired).
    Bring-up found one design bug and needed three build options:
    - HP_DET=adc: on v0.3 the plug detect can't reach a digital high. R3 (100k)
    pulls it up through R5 (10k) into Q1's base-emitter junction, so it sits
    at about 0.8 V with a plug in (0 V without) and D13 reads low either way,
    leaving the headphone amp muted forever. With a wire from EXP pin 8 to
    EXP pin 4 the firmware reads the node through the ADC on A5 instead, with
    a 0.5 V threshold, hysteresis and the same debounce. Verified: headphones
    play. Proper fix (Q1 as a 2N7002)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
    [synthMachine.cpp]
2026-09-17 Carrier v0.4: KiCad revision with the NEXT_REVISION fixes, plus HW=carrier4
    New hardware/v0.4/ generated, autorouted (Freerouting 2.4.1, Java 25) and
    checked: ERC clean, DRC 0 unconnected, only the usual silk warnings and
    thermal-spoke notes. v0.3 in hardware/ is untouched.
    Board changes (all from NEXT_REVISION.md):
    - Q1 is a 2N7002 MOSFET: HP_DET reaches 3V3, D13 reads the plug directly.
    - Firmware mute on its own 2N7002 (Q2) from D0, 10k pull-up: speakers
    muted at reset/DFU/crash, push-pull drive, wired-OR with Q1 on AMP_SD.
    - J15 STEMMA QT on I2C1 (D11 SCL, D12 SDA) for seesaw encoders, with DNP
    4k7 pull-up footprints.
    - J9 display header on hardware SPI1 (A7 SCK, A3 MOSI, A8 NSS) +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
    [digikey_tht_parts.csv, synth_machine.kicad_pcb, synth_machine.kicad_sch]
2026-09-17 Next revision: port the key-row, RGB LED and LiPo notes from the stray branch
    These three ideas lived only in a one-commit branch
    (claude/board-redesign-connectors-power-c52nwy) that appended them to the
    hardware README and was never merged. Carried into Worth considering,
    adjusted for v0.4's pin assignments; the branch can go.
    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
2026-09-17 hardware/: v0.3 and v0.4 as sibling directories
    The fabricated revision moves from hardware/ into hardware/v0.3/ (git mv,
    history preserved) so it sits next to v0.4/. hardware/README.md becomes a
    short index of the revisions; NEXT_REVISION.md and enclosure-concepts/
    stay at the hardware/ level since they span revisions. Every path
    reference follows: the two READMEs, fab.sh and route.py usage comments,
    the v0.3 generator's title-block comment, Makefile, WIRING.md, the
    firmware's profile comments and .gitignore.
    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
    [digikey_tht_parts.csv, synth_machine.kicad_pcb, synth_machine.kicad_sch]
2026-09-17 Carrier v0.4: landscape board with one key row and onboard LiPo power
    Rebuilt from the two remaining next-revision ideas (the RGB LED one is
    dropped):
    - 160 x 74 mm outline. All 19 key headers in one row along the bottom
    edge in panel order, rotated for a 7 mm pitch (132 mm wide), diode above
    each header and the key name below it. Pots stacked up the right edge,
    EXP and DISP headers along the top, mounting holes in the corners.
    - Battery: BQ24074 charger with power path (1.5 A input limit via R19,
    0.5 A charge via R18, default timers, TS 10k), TPS61023 boost to 5.1 V
    (750k/100k, 1 uH XEL4030, 10 uF in, 2 x 22 uF out + C1), JST-PH cell on
    J17, panel power switch on J16 driving th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
    [digikey_tht_parts.csv, synth_machine.kicad_pcb, synth_machine.kicad_sch]
2026-09-17 Carrier v0.4: bank pots replaced by I2C encoders; volume pot only
    J11..J14 are gone. J10 (volume, A0) stays on the right edge; the four bank
    controls are seesaw rotary encoders on J15 (STEMMA QT, I2C1), now placed
    mid-height on the right edge. A1/A2/A4/A9 go to the expansion header,
    which grows to 1x12; DISP moves right to make room.
    Pre-routes added for the charger's OUT and EN2 pins (0.5 mm pitch QFN) so
    the VSYS rail always completes. Routed: DRC 0 unconnected, ERC clean.
    Firmware HW=carrier4: reads A0 only and leaves the bank inputs alone (they
    float without pots); encoder support is still to come. Docs, Digi-Key list
    and NEXT_REVISION updated; the encoder item is marked done in hardwa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
    [digikey_tht_parts.csv, synth_machine.kicad_pcb, synth_machine.kicad_sch]
2026-09-17 Carrier v0.4: top-entry STEMMA QT at the top right, volume header on the left edge, jack 1.5 mm proud
    - J15 becomes the vertical JST SH (BM04B-SRSS-TB, LCSC C160390) at the top
    right so the encoder cable leaves upward toward the panel; the DNP
    pull-ups follow it. Top-right mounting hole back at (155, 4).
    - J10 (volume pot) moves to the left edge under the USB-C, matching where
    the pot sits on the panel.
    - J7 headphone jack moved 1.5 mm toward the top edge; its nose now stands
    proud of the board edge instead of flush.
    - One more pre-route (FB divider to +5V) so the boost cluster routes every
    time. DRC 0 unconnected, ERC clean.
    - README: connector table, J15 pin-1 check, note that F1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
    [synth_machine.kicad_pcb, synth_machine.kicad_sch]
2026-09-17 Carrier v0.4: power-switch header on the left edge, jumpers given room
    - J16 (panel power switch) moves to the left edge at mid-height, with JP2
    (always-on bridge) beside it instead of in the battery cluster.
    - JP1 (amp gain) moves into the channel above the key diodes, clear of
    R13/R14 and the diodes, instead of squeezed between two diodes.
    - Headphone-amp passive columns shifted 1 mm left so the router no longer
    needs a 0.1 mm neck past R9; route.py also widens any sub-minimum stub
    Freerouting leaves, in the pour step.
    - +5V trunk from the boost to the display header pre-routed; the boost
    cluster now routes identically every run. DRC 0 unconnected, ERC clean.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
    [synth_machine.kicad_pcb, synth_machine.kicad_sch]
2026-09-17 Carrier v0.4: JP2 4 mm further from J16 so the PWR SW label reads
    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
    [synth_machine.kicad_pcb, synth_machine.kicad_sch]
2026-09-17 Carrier v0.4: quality pass on current paths and the boost cluster
    Audit of every current-carrying net on the routed board, and fixes:
    - Boost converter (SOT-563, 0.5 mm pitch rows at y 39.5/40.0/40.5): 0.3 mm
    necks off VIN/SW/VOUT/GND no longer than the pitch forces, then 0.6 mm
    into the input cap, the inductor and the output cap. Previously 0.25 mm
    for several millimetres in series with the whole battery current.
    - MAX98306 PVDD pins joined right off the pads into one 0.5 mm feed; the
    four speaker lines widen to 0.4 mm as soon as they separate. Previously
    0.2 mm for the full 6 to 15 mm runs.
    - +5V trunk hand-routed on both layers from the boost to the display and
    expansion heade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
    [synth_machine.kicad_pcb, synth_machine.kicad_sch]
2026-09-17 Carrier v0.4: peripheral 3.3 V rail (AP7361C-33) for encoders, display and EXP
    U7, a 1 A SOT-223 LDO on +5V, makes 3V3P for the STEMMA QT connector, the
    display header, the expansion header's 3V3 pin and the DNP I2C pull-ups.
    The Seed's regulator now carries only the Seed, the headphone amp and the
    pull-ups, so the encoder boards' NeoPixels can no longer sag it. Pinout
    (1 IN, 2 GND tab, 3 OUT) checked against the AP7361C datasheet's SOT223
    column; 10 uF each side placed against the footprint's stacked pins; +5V
    pre-routed from the trunk to the input pin and cap, 3V3P to the output
    cap. Routed: DRC 0 unconnected, ERC clean. README power section and
    header tables updated.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
    [synth_machine.kicad_pcb, synth_machine.kicad_sch]
2026-09-17 carrier4: keep A3 out of the ADC config, it is the display's SPI MOSI on v0.4
    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
2026-09-18 Carrier v0.4: JP1 (amp gain) moved to the open area right of the speaker connectors
    4 mm or more clear on every side for soldering; it was 2 mm from the key
    diode row. DRC 0 unconnected, ERC clean.
    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
    [synth_machine.kicad_pcb, synth_machine.kicad_sch]
2026-09-18 Carrier v0.4: 1.5 mm between U7 and its capacitors
    C27 was 0.13 mm from the regulator's courtyard and C28 0.84 mm; U7 moved
    1.5 mm down and C28 2 mm down. DRC 0 unconnected, ERC clean.
    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
    [synth_machine.kicad_pcb, synth_machine.kicad_sch]
2026-09-18 Carrier v0.4: USB-C receptacle is the HRO TYPE-C-31-M-12 (in stock at JLCPCB)
    The GCT USB4105-GF-A went out of stock at LCSC. The HRO part has the
    same shell holes and pad pitch (pad row 0.36 mm further in) and the same
    body depth, so J1 keeps its place on the top edge; KiCad's footprint for
    it is used, so the pads match the part exactly. LCSC C165948, a JLCPCB
    basic part. F1 moved 1.5 mm to clear the slightly larger courtyard.
    Re-routed: DRC 0 unconnected, ERC clean. Gerbers, BOM and CPL regenerated.
    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
    [digikey_tht_parts.csv, synth_machine.kicad_pcb, synth_machine.kicad_sch]
2026-09-18 Carrier v0.4: JST headers and sockets placed by JLCPCB standard assembly
    LCSC numbers on the 19 key headers, the volume and switch headers (JST XH
    C158012 / C144394) and the speaker and battery sockets (JST PH C131337);
    the JLCPCB placement export now includes through-hole parts. README and
    Digi-Key list say which parts remain hand-fitted.
    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
    [synth_machine.kicad_pcb, synth_machine.kicad_sch]
2026-09-18 v0.4 README and Digi-Key list: JLCPCB standard assembly places the JST connectors
    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
    [digikey_tht_parts.csv]
